gryumov/stm32-balancing-robot/firmware/README.ru.md

# Программа робота

 

[← О проекте](../README.ru.md)

## Сборка

Проект: [keil/robot.uvprojx](keil/robot.uvprojx), микроконтроллер **STM32F103C8**.

Среда: Keil µVision, ARM Compiler **5.06 update 6**, пакет **Keil.STM32F1xx_DFP 2.3.0** и **ARM.CMSIS 5.5.1**. Установите эти пакеты в Keil, откройте проект и выполните **Rebuild**.

## Где что находится

| Файл | Назначение |
| --- | --- |
| [src/main.c](src/main.c) | Запуск датчика, таймера и привода |
| [src/balance.c](src/balance.c) | Чтение измерений, фильтр и регулятор в прерывании TIM4 |
| [src/mpu6050.c](src/mpu6050.c) | Настройка акселерометра и гироскопа |
| [src/i2c.c](src/i2c.c) | Обмен по I²C через регистры STM32 |
| [src/motors.c](src/motors.c) | ШИМ, направление моторов и энкодеры |
| [src/uart.c](src/uart.c) | Последовательный интерфейс |
| [inc/robot_config.h](inc/robot_config.h) | Коэффициенты регулятора, фильтров и пересчета энкодеров |
| [inc/mpu6050.h](inc/mpu6050.h) | Регистры датчика и коэффициенты чувствительности |

## Управление равновесием

На каждом шаге угол оценивается так:

```text
угол = 0,98 × (предыдущий угол + угловая скорость × dt)
     + 0,02 × угол по акселерометру
```

Регулятор учитывает угол, угловую скорость, перемещение и скорость колес. Коэффициенты K1–K5 в [robot_config.h](inc/robot_config.h) подбираются под моторы и корпус. Они объявлены как `volatile`, поэтому их можно менять и через отладчик. В коде стоят значения для моего робота.

## Первый запуск

Начните с вывешенными колесами. Проверьте показания наклона и направление вращения моторов, затем переходите к настройке коэффициентов.

## Сторонний код

Определения регистров в `inc/mpu6050.h` взяты из [I2Cdevlib Джеффа Роуберга](https://github.com/jrowberg/i2cdevlib/blob/master/Arduino/MPU6050/MPU6050.h). Их лицензия MIT приведена в заголовке.

Файлы поддержки ST и ARM в `keil/RTE` взяты из [пакета Keil.STM32F1xx_DFP 2.3.0](https://www.keil.com/pack/Keil.STM32F1xx_DFP.2.3.0.pack), исходные уведомления сохранены. Все остальное распространяется по лицензии MIT, см. [LICENSE](../LICENSE).
