gryumov/stm32-balancing-robot/THIRD-PARTY-NOTICES.md

# Third-party notices

The project itself is under the MIT license, see [LICENSE](LICENSE). The following components are distributed under their own terms, which are preserved in the respective files.

- firmware/inc/mpu6050.h — register definitions adapted from Jeff Rowberg's
  I2Cdevlib, MIT License (notice included in the header).
- firmware/keil/RTE/Device/STM32F103C8/system_stm32f10x.c and
  startup_stm32f10x_md.s — STMicroelectronics CMSIS device support files from
  the Keil.STM32F1xx_DFP 2.3.0 pack, original notices preserved.
- firmware/keil/RTE/Device/STM32F103C8/RTE_Device.h — ARM Ltd., zlib-style
  license included in the file.
- 3D component models embedded in hardware/pcb/controller.PcbDoc are provided
  by their respective manufacturers and remain their property.
