gryumov/stm32-balancing-robot/hardware/pcb/controller-schematic.pdf

DD2 | STM³²F¹03C8T⁶
Цепь | Конт.

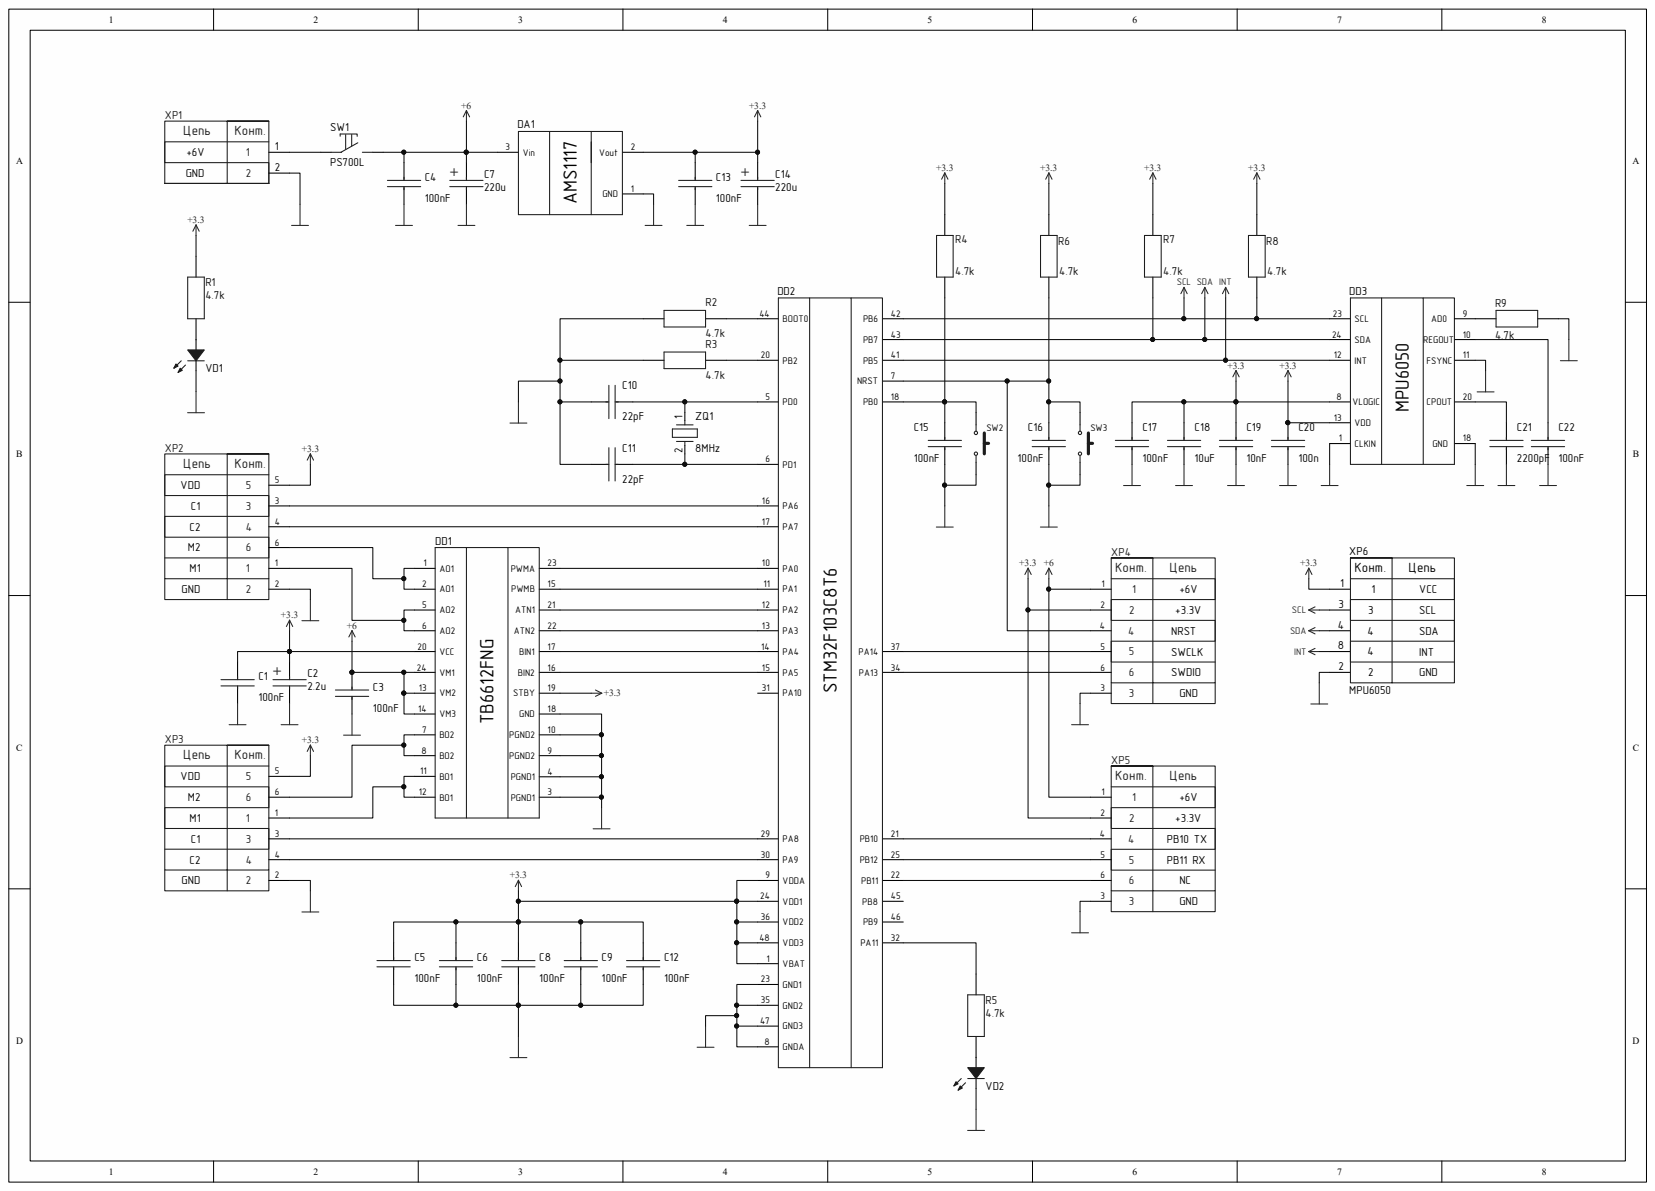
[picture p4: page 1]

Цепь | Конт.
