gryumov/stm32-balancing-robot/(list of files, drawings)

Other design files:
hardware/pcb/controller.PcbDoc
hardware/pcb/controller.PrjPCB
hardware/pcb/controller.SchDoc
